vfadlan/atmostag/analysis-and-planning/README.md

# About This Section
This section is an engineering note about design process of this project. Some files on this will also be reposted on Hackaday.io.

## TODO
- CR2032 Analysis
- EPD Boost Driver Characteristic
- Power Budget: STM32L0, SHT41, UV Sensor, EPD Boost Driver
- State Machine
