vfadlan/atmostag/design-files/cad/references/cr2032-bs6-holder.webp

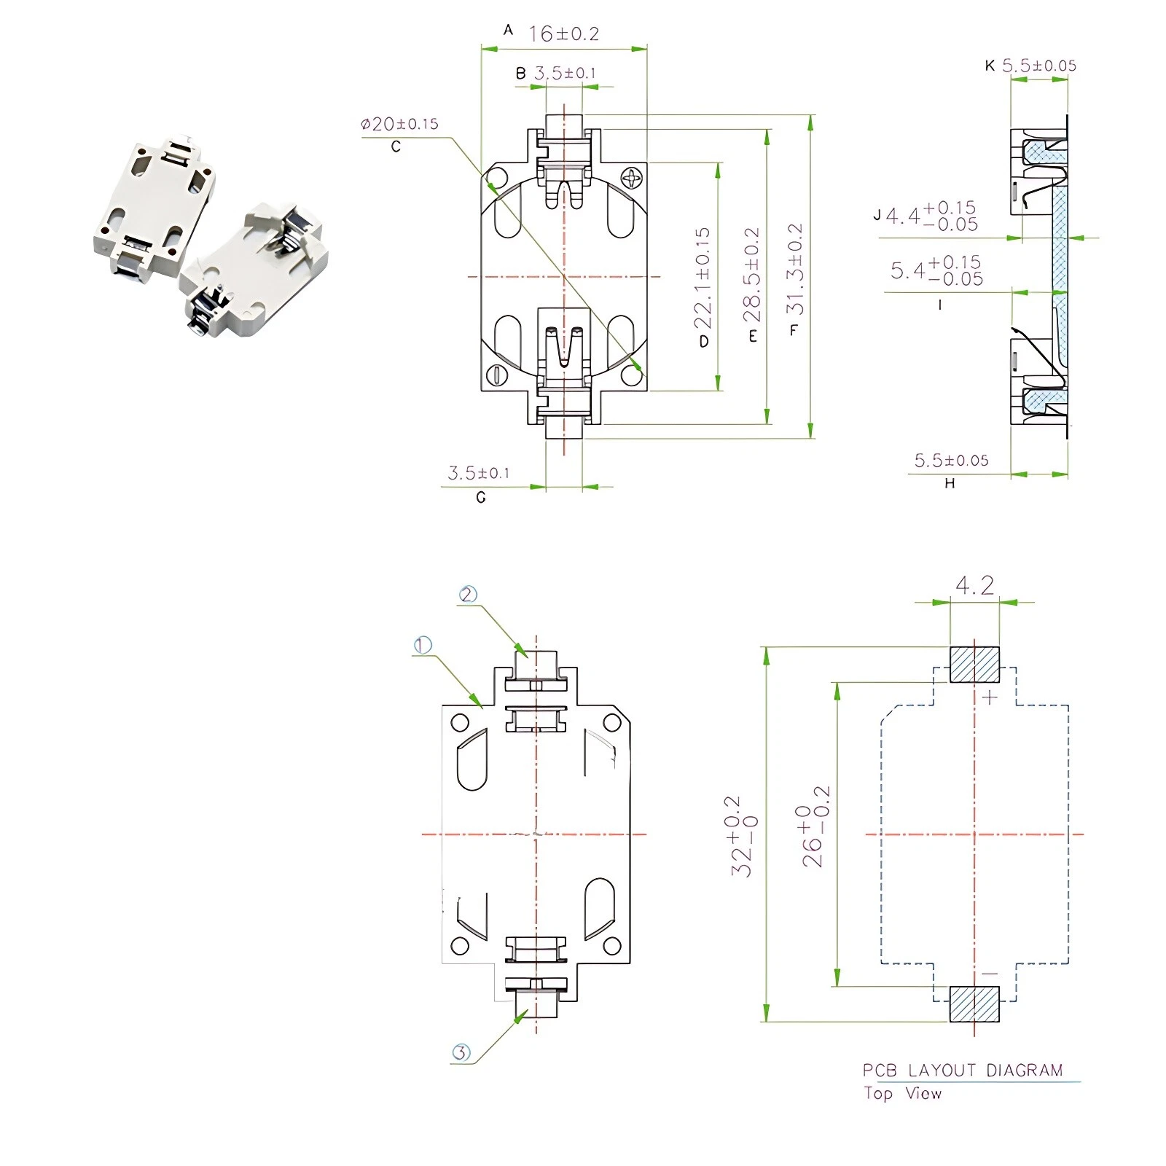
design-files/cad/references/cr2032-bs6-holder.webp
