vfadlan/atmostag/design-files/cosmetics/handdrawn-silkscreen-2.png

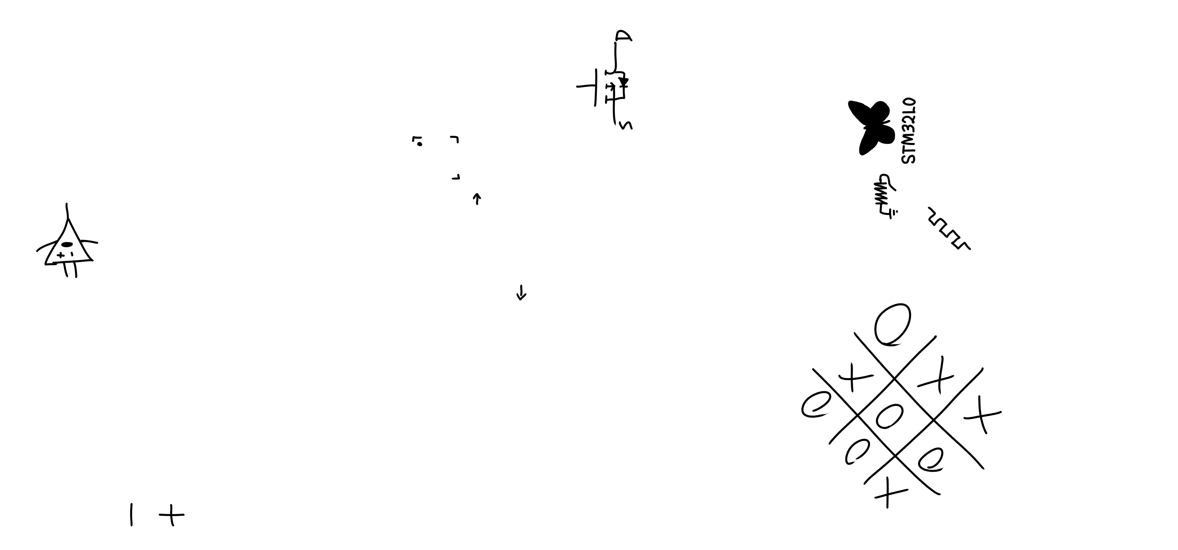
design-files/cosmetics/handdrawn-silkscreen-2.png
