vfadlan/atmostag/design-files/cosmetics/handdrawn-silkscreen.png

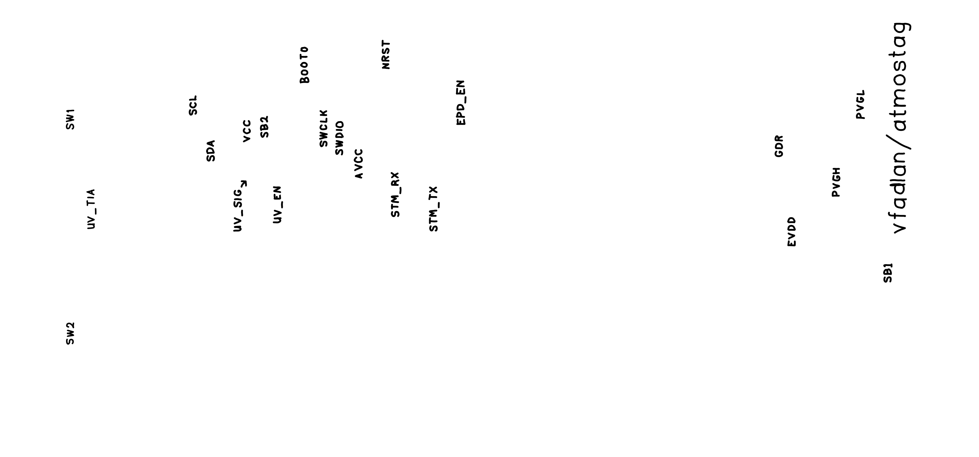
design-files/cosmetics/handdrawn-silkscreen.png
