vfadlan/atmostag/design-files/electrical/BOM_Main Board_AtmosTag_2026-10-05.csv

No. | Quantity | Comment | Designator | Footprint | Value | Manufacturer Part | Manufacturer | Supplier Part | Supplier | JLCPCB Stock | JLCPCB Price | LCSC Stock | LCSC Price | Category
1 | 1 | AGND | AGND | Test-Point-0.5mm |  |  |  |  |  |  |  |  | 0.0025
2 | 1 | AVCC | AVCC | Test-Point-0.5mm |  |  |  |  |  |  |  |  | 0.0025
3 | 1 | BOOT0 | BOOT0 | Test-Point-0.5mm |  |  |  |  |  |  |  |  | 0.0025
4 | 13 | 100nF | C1,C4,C5,C6,C8,C9,C10,C24,C25,C27,C30,C31,C32 | C0402 | 100nF | CL05B104KO5NNNC | SAMSUNG(三星) | C1525 | LCSC | 22154150 | 0.0007 |  |  | Capacitors:Multilayer Ceramic Capacitors MLCC - SMD/SMT
5 | 2 | 10pF | C2,C3 | C0402 | 10pF | CL05C100JB5NNNC | SAMSUNG(三星) | C32949 | LCSC | 1179858 | 0.0009 |  |  | Capacitors:Multilayer Ceramic Capacitors MLCC - SMD/SMT
6 | 2 | 100uF | C7,C23 | CASE-B_3528 | 100uF | TAJB107K006RNJ | Kyocera AVX | C16133 | LCSC | 612969 | 0.0397 |  |  | Capacitors:Tantalum Capacitors
7 | 10 | 1uF | C11,C12,C13,C14,C15,C16,C17,C18,C19,C20 | C0402 | 1uF | CL05A105KA5NQNC | SAMSUNG(三星) | C52923 | LCSC | 8338493 | 0.0017 |  |  | Capacitors:Multilayer Ceramic Capacitors MLCC - SMD/SMT
8 | 2 | 4.7uF | C21,C22 | C1206 | 4.7uF | 1206B475K500NT | FH(风华) | C29823 | LCSC | 592679 | 0.0252 |  |  | Capacitors:Multilayer Ceramic Capacitors MLCC - SMD/SMT
9 | 3 | 4.7uF | C26,C28,C33 | C0603 | 4.7uF | CL10A475KO8NNNC | SAMSUNG(三星) | C19666 | LCSC | 2518075 | 0.0045 |  |  | Capacitors:Multilayer Ceramic Capacitors MLCC - SMD/SMT
10 | 3 | MBR0530 | D1,D2,D3 | SOD-123_L2.7-W1.6-LS3.7-RD-1 |  | MBR0530 | DOWO(东沃) | C22378361 | LCSC | 3680 | 0.0022 |  |  | Diodes:Schottky Diodes
11 | 3 | ESD321DPYR-TP | D4,D5,D6 | X1SON-2_L1.0-W0.6-P0.65-RD |  | ESD321DPYR-TP | TECH PUBLIC(台舟) | C19829523 | LCSC | 19037 | 0.008 |  |  | Circuit Protection:ESD and Surge Protection (TVS/ESD)
12 | 1 | EPD_EN | EPD_EN | Test-Point-0.5mm |  |  |  |  |  |  |  |  | 0.0025
13 | 3 | Test-Point | EPD_VDD,TP1,TP2 | Test-Point-0.5mm |  |  |  |  |  |  |  |  | 0.0025
14 | 1 | FH34SRJ-24S-0.5SH(50) | FPC1 | FFC-SMD_24P-P0.50_FH34SRJ-24S-0.5SH |  | FH34SRJ-24S-0.5SH(50) | HRS(广濑) | C324726 | LCSC | 6516 | 0.0372 |  |  | Connectors:FFC, FPC (Flat Flexible) Connector Assemblies
15 | 1 | GDR | GDR | Test-Point-0.5mm |  |  |  |  |  |  |  |  | 0.0025
16 | 1 | GND | GND | Test-Point-0.5mm |  |  |  |  |  |  |  |  | 0.0025
17 | 1 | PZ254V-11-02P | H1 | HDR-TH_2P-P2.54-V-M |  | PZ254V-11-02P | XFCN(兴飞) | C492401 | LCSC | 1262495 | 0.0028 |  |  | Connectors:Pin Headers
18 | 1 | GZ2012D601TF | L1 | L0805 |  | GZ2012D601TF | Sunlord(顺络) | C1017 | LCSC | 366222 | 0.0031 |  |  | Filters:Ferrite Beads
19 | 3 | KT-0603W | LED1,LED2,LED3 | LED0603-R-RD_WHITE |  | KT-0603W | KENTO | C2290 | LCSC | 2115580 | 0.0019 |  |  | Optoelectronics:LED Indication - Discrete
20 | 1 | NRST | NRST | Test-Point-0.5mm |  |  |  |  |  |  |  |  | 0.0025
21 | 1 | GUVA-S12SD | PD1 | LED-SMD_L3.2-W2.8-RD |  | GUVA-S12SD | Genicom | C7200747 | LCSC | 0 | 1.8313 |  |  | Optoelectronics:Photodiodes
22 | 1 | PREVGH | PREVGH | Test-Point-0.5mm |  |  |  |  |  |  |  |  | 0.0025
23 | 1 | PREVGL | PREVGL | Test-Point-0.5mm |  |  |  |  |  |  |  |  | 0.0025
24 | 3 | AO3401A | Q1,Q2,Q4 | SOT-23_L2.9-W1.3-P1.90-LS2.4-BR |  | AO3401A | AOS | C15127 | LCSC | 757758 | 0.0153 |  |  | Transistors/Thyristors:MOSFETs
25 | 1 | SI1304BDL | Q3 | SOT-323-3_L2.0-W1.3-P1.30-LS2.1-BL |  | SI1304BDL | TECH PUBLIC(台舟) | C7419947 | LCSC | 3993 | 0.0091 |  |  | Transistors/Thyristors:MOSFETs
26 | 2 | 4.7kΩ | R1,R2 | R0603 | 4.7kΩ | 0603WAF4701T5E | UNI-ROYAL(厚声) | C23162 | LCSC | 22388782 | 0.0005 |  |  | Resistors:Chip Resistor - Surface Mount
27 | 1 | 1MΩ | R3 | R0603 | 1MΩ | 0603WAF1004T5E | UNI-ROYAL(厚声) | C22935 | LCSC | 6583768 | 0.0003 |  |  | Resistors:Chip Resistor - Surface Mount
28 | 1 | 3.3kΩ | R4 | R0402 | 3.3kΩ | 0402WGF3301TCE | UNI-ROYAL(厚声) | C25890 | LCSC | 2081969 | 0.0006 |  |  | Resistors:Chip Resistor - Surface Mount
29 | 3 | 1kΩ | R5,R6,R14 | R0402 | 1kΩ | 0402WGF1001TCE | UNI-ROYAL(厚声) | C11702 | LCSC | 7096292 | 0.0003 |  |  | Resistors:Chip Resistor - Surface Mount
30 | 1 | 2.2kΩ | R7 | R0402 | 2.2kΩ | 0402WGF2201TCE | UNI-ROYAL(厚声) | C25879 | LCSC | 2212616 | 0.0002 |  |  | Resistors:Chip Resistor - Surface Mount
31 | 2 | 470kΩ | R8,R11 | R0603 | 470kΩ | 0603WAF4703T5E | UNI-ROYAL(厚声) | C23178 | LCSC | 1450342 | 0.0005 |  |  | Resistors:Chip Resistor - Surface Mount
32 | 2 | 0Ω | R9,R18 | R0603 | 0Ω | 0603WAF0000T5E | UNI-ROYAL(厚声) | C21189 | LCSC | 23699129 | 0.0004 |  |  | Resistors:Chip Resistor - Surface Mount
33 | 1 | 3Ω | R10 | R0603 | 3Ω | ESR03EZPF3R00 | ROHM(罗姆) | C3960622 | LCSC | 753 | 0.002 |  |  | Resistors:Chip Resistor - Surface Mount
34 | 2 | 10kΩ | R12,R17 | R0402 | 10kΩ | 0402WGF1002TCE | UNI-ROYAL(厚声) | C25744 | LCSC | 21656419 | 0.0006 |  |  | Resistors:Chip Resistor - Surface Mount
35 | 3 | 100Ω | R13,R15,R16 | R0603 | 100Ω | 0603WAF1000T5E | UNI-ROYAL(厚声) | C22775 | LCSC | 11539242 | 0.0005 |  |  | Resistors:Chip Resistor - Surface Mount
36 | 2 | Solder-Bridge-3P | SB1,SB2 | Solder-Bridge-3P |  |  |  |  |  |  |  |  | 0.0025
37 | 2 | G4R153312 | SW1,SW2 | SW-SMD_4P-L5.2-W5.2-P3.70-LS6.4_UK-B0233XX |  | G4R153312 | SAMZO(三佐) | C49393650 | LCSC | 3842 | 0.0133 |  |  | Switches:Tactile Switches
38 | 1 | SWCLK | SWCLK | Test-Point-0.5mm |  |  |  |  |  |  |  |  | 0.0025
39 | 1 | SWDIO | SWDIO | Test-Point-0.5mm |  |  |  |  |  |  |  |  | 0.0025
40 | 1 | STM32L031G6U6 | U1 | UFQFPN-28_L4.0-W4.0-P0.50-BL |  | STM32L031G6U6 | ST(意法半导体) | C96514 | LCSC | 0 | 0.2963 |  |  | Embedded Processors & Controllers:Microcontrollers (MCU/MPU/SOC)
41 | 1 | SHT41-P-NF | U2 | DFN-4_L1.5-W1.5-SHT41-AD1B-R2 |  | SHT41-P-NF | Nyfea(徕飞) | C55108905 | LCSC | 1541 | 0.2342 |  |  | Sensors:Temperature and Humidity Sensor
42 | 1 | MCP6002-I/MS | U3 | MSOP-8_L3.0-W3.0-P0.65-LS4.9-BL |  | MCP6002-I/MS | MICROCHIP(美国微芯) | C5121360 | LCSC | 65 | 0.1047 |  |  | Amplifiers/Comparators:Operational Amplifier
43 | 1 | CP2102N-A02-GQFN20R | U4 | QFN-20_L3.0-W3.0-P0.50-BL-EP1.7_EFM8BB21F16G |  | CP2102N-A02-GQFN20R | SKYWORKS/SILICON LABS(芯科) | C969913 | LCSC | 11364 | 0.2748 |  |  | Interface:USB Converters
44 | 1 | 47uH | U5 | IND-SMD_L3.0-W3.0_CDRH2D18-HPNP | 47uH | CDRH2D18/LDNP-470NC | Sumida(胜美达) | C2454210 | LCSC | 0 | 0.0834 |  |  | Inductors, Coils, Chokes:Power Inductors
45 | 2 | 74LVC1G126GW | U6,U7 | SOT-353-5_L2.0-W1.6-P0.65-LS2.1-BL |  | 74LVC1G126GW | MDD(辰达半导体) | C52140429 | LCSC | 4936 | 0.0102 |  |  | Logic:Buffers, Drivers, Receivers, Transceivers
46 | 1 | USB-MICRO XNJ JB | USB1 | MICRO-USB-SMD_HX-USB-MICRO-XNJ-JB |  | USB-MICRO XNJ JB | SHOU HAN(首韩) | C7507410 | LCSC | 18405 | 0.0059 |  |  | Connectors:USB Connectors
47 | 1 | UV_EN | UV_EN | Test-Point-0.5mm |  |  |  |  |  |  |  |  | 0.0025
48 | 1 | UV | UV_SEG | Test-Point-0.5mm |  |  |  |  |  |  |  |  | 0.0025
49 | 1 | TIA | UV_TIA | Test-Point-0.5mm |  |  |  |  |  |  |  |  | 0.0025
50 | 1 | VCC | VCC | Test-Point-0.5mm |  |  |  |  |  |  |  |  | 0.0025
51 | 1 | 32.768kHz | X1 | OSC-SMD_L3.2-W1.5 | 32.768kHz | SC-32S32.768kHz20PPM7pF | Seiko(精工) | C97604 | LCSC | 155016 | 0.0281 |  |  | Crystals, Oscillators, Resonators:Crystals
