vfadlan/atmostag/design-files/cad/Assembly.SLDASM

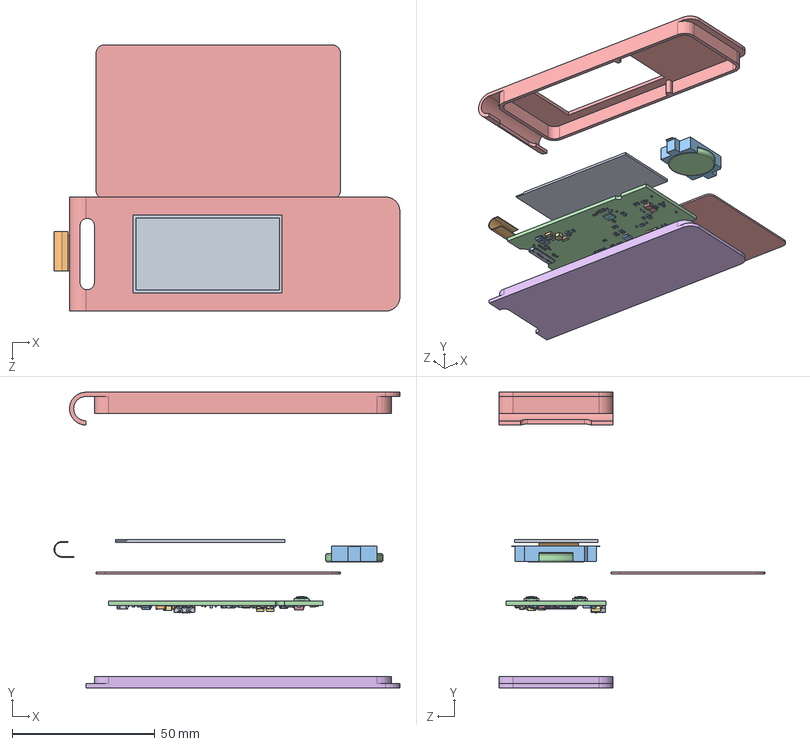
[picture p20: CAD file, 2026-10-23]
design-files/cad/Assembly.SLDASM
121.1 x 103.5 x 93.2 mm
2.13-EPD-Screen
Flex-Cable^Assembly
CR2032-BS6-Holder
CR2032
C0402~C0402_L1.0-W0.5-H0.5~13V8.step x 26
CASE-B_3528~CASE-B_L3.5-W2.8-H1.9~MT1c.step x 2
C0603~C0603_L1.6-W0.8-H0.8~z3cm.step x 3
X1SON-2_L1.0-W0.6-P0.65-RD~X1SON-2_L1.0-W0.6-P0.65-RD~nRyh.step x 3
C1206~C1206_L3.2-W1.6-H1.3~bCKY.step x 2
SOD-123_L2.7-W1.6-LS3.7-RD-1~SOD-123_L2.7-W1.6-LS3.7-RD-1~3PoL.step x 3
L0805~R0805_L2.0-W1.3-H0.6~qKtJ.step
LED-SMD_L3.2-W2.8-RD~LED-SMD_L3.5-W2.8-H1.4~aKe1.step
LED0603-R-RD_WHITE~LED0603-R-RD_WHITE~N99n.step x 3
SOT-323-3_L2.0-W1.3-P1.30-LS2.1-BL~SOT-323-3_L2.0-W1.3-P1.30-LS2.1-BL~gQnD.step
R0603~R0603~ZJ5j.step x 11
FFC-SMD_24P-P0.50_FH34SRJ-24S-0.5SH~FFC-SMD_24P-P0.50_FH34SRJ-24S-0.5SH~vgLo.step
R0402~R0402_L1.0-W0.5-H0.4~BaNc.step x 8
SOT-23_L2.9-W1.3-P1.90-LS2.4-BR~SOT-23-3P_L2.9-W1.3-H1.0-LS2.4-P0.95~FBFc.step x 3
SW-SMD_4P-L5.2-W5.2-P3.70-LS6.4_UK-B0233XX~SW-SMD_4P-L5.2-W5.2-H1.5-P3.70-LS5.4_UK-B0232XX~TJl1.step x 2
MSOP-8_L3.0-W3.0-P0.65-LS4.9-BL~MSOP-8_L3.0-W3.0-H1.1-LS4.9-P0.65~WqGd.step
DFN-4_L1.5-W1.5-SHT41-AD1B-R2~DFN-4_L1.5-W1.5-SHT41-AD1B-R2~EiRA.step
IND-SMD_L3.0-W3.0_CDRH2D18-HPNP~IND-SMD_L3.0-W3.0-H1.8_CDRH2D18-HPNP~dVXh.step
UFQFPN-28_L4.0-W4.0-P0.50-BL~UFQFPN-28_L4.0-W4.0-H0.6-P0.50~cQHD.step
MICRO-USB-SMD_HX-USB-MICRO-XNJ-JB~MICRO-USB-SMD_HX-USB-MICRO-XNJ-JB~raZj.step
OSC-SMD_L3.2-W1.5~OSC-SMD_L3.2-W1.5-H0.8~C9HM.step
QFN-20_L3.0-W3.0-P0.50-BL-EP1.7_EFM8BB21F16G~QFN-20_L3.0-W3.0-H0.8-P0.50~cjvo.step
Board~wIS8.step
Top-Shell^Assembly
Bottom-Shell^Assembly
