vfadlan/atmostag/design-files/cad/3DPCB_AtmosTag-v1.3_2026-10-09.SLDASM

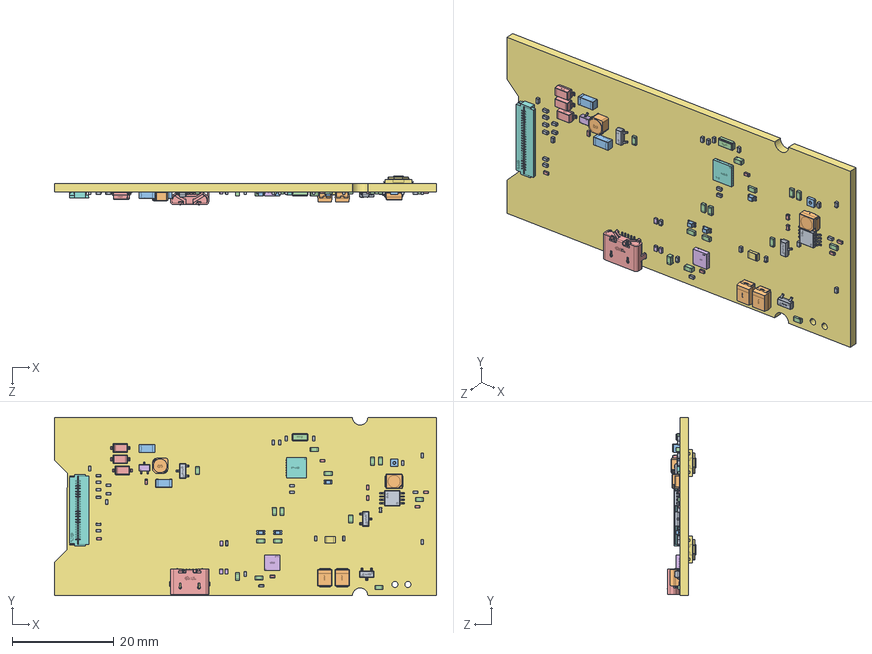
[picture p21: CAD file, 2026-10-23]
design-files/cad/3DPCB_AtmosTag-v1.3_2026-10-09.SLDASM
75.0 x 35.0 x 5.75 mm
C0402~C0402_L1.0-W0.5-H0.5~6r8q.step x 26
CASE-B_3528~CASE-B_L3.5-W2.8-H1.9~lpej.step x 2
C1206~C1206_L3.2-W1.6-H1.3~HpHm.step x 2
C0603~C0603_L1.6-W0.8-H0.8~5elm.step x 3
SOD-123_L2.7-W1.6-LS3.7-RD-1~SOD-123_L2.7-W1.6-LS3.7-RD-1~J5fz.step x 3
X1SON-2_L1.0-W0.6-P0.65-RD~X1SON-2_L1.0-W0.6-P0.65-RD~9xGz.step x 3
L0805~R0805_L2.0-W1.3-H0.6~Wi9K.step
FFC-SMD_24P-P0.50_FH34SRJ-24S-0.5SH~FFC-SMD_24P-P0.50_FH34SRJ-24S-0.5SH~g9HX.step
SOT-23_L2.9-W1.3-P1.90-LS2.4-BR~SOT-23-3P_L2.9-W1.3-H1.0-LS2.4-P0.95~2eBH.step x 3
LED-SMD_L3.2-W2.8-RD~LED-SMD_L3.5-W2.8-H1.4~j0iY.step
LED0603-R-RD_WHITE~LED0603-R-RD_WHITE~vOEA.step x 3
R0603~R0603~y4nU.step x 11
R0402~R0402_L1.0-W0.5-H0.4~89QX.step x 8
SOT-323-3_L2.0-W1.3-P1.30-LS2.1-BL~SOT-323-3_L2.0-W1.3-P1.30-LS2.1-BL~Mjdz.step
SW-SMD_4P-L5.2-W5.2-P3.70-LS6.4_UK-B0233XX~SW-SMD_4P-L5.2-W5.2-H1.5-P3.70-LS5.4_UK-B0232XX~Gqr3.step x 2
UFQFPN-28_L4.0-W4.0-P0.50-BL~UFQFPN-28_L4.0-W4.0-H0.6-P0.50~kUiK.step
MSOP-8_L3.0-W3.0-P0.65-LS4.9-BL~MSOP-8_L3.0-W3.0-H1.1-LS4.9-P0.65~v4GR.step
IND-SMD_L3.0-W3.0_CDRH2D18-HPNP~IND-SMD_L3.0-W3.0-H1.8_CDRH2D18-HPNP~sAZQ.step
DFN-4_L1.5-W1.5-SHT41-AD1B-R2~DFN-4_L1.5-W1.5-SHT41-AD1B-R2~CHCD.step
OSC-SMD_L3.2-W1.5~OSC-SMD_L3.2-W1.5-H0.8~YgzL.step
MICRO-USB-SMD_HX-USB-MICRO-XNJ-JB~MICRO-USB-SMD_HX-USB-MICRO-XNJ-JB~2A1r.step
QFN-20_L3.0-W3.0-P0.50-BL-EP1.7_EFM8BB21F16G~QFN-20_L3.0-W3.0-H0.8-P0.50~Kgs7.step
Board~EWOM.step
