vfadlan/atmostag/design-files/cad/PCB_Placeholder.SLDPRT

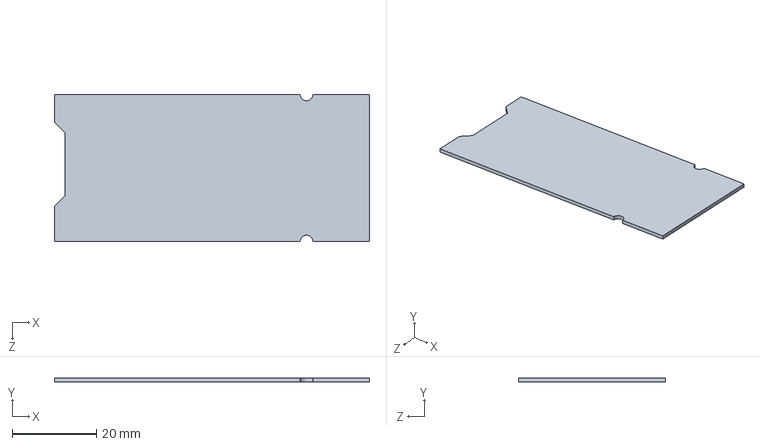
[picture p22: CAD file, 2026-10-23]
design-files/cad/PCB_Placeholder.SLDPRT
75.0 x 1.00 x 35.0 mm
