vfadlan/atmostag/design-files/cad/2.13-EPD-Screen.SLDPRT

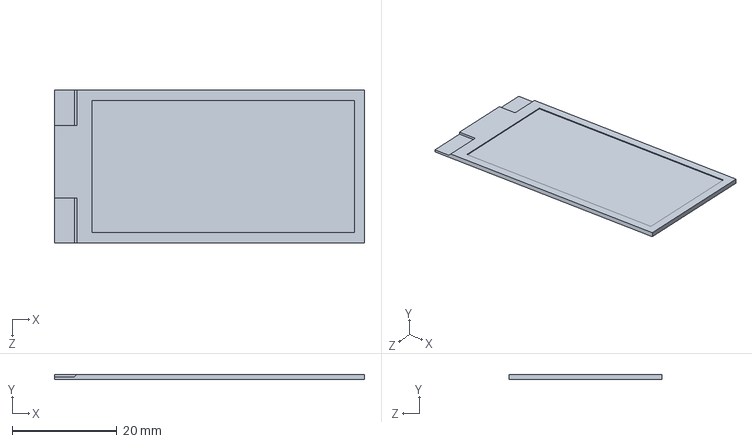
[picture p23: CAD file, 2026-10-23]
design-files/cad/2.13-EPD-Screen.SLDPRT
59.2 x 1.00 x 29.2 mm
