vfadlan/atmostag/design-files/cad/CR2032-BS6-Holder.SLDPRT

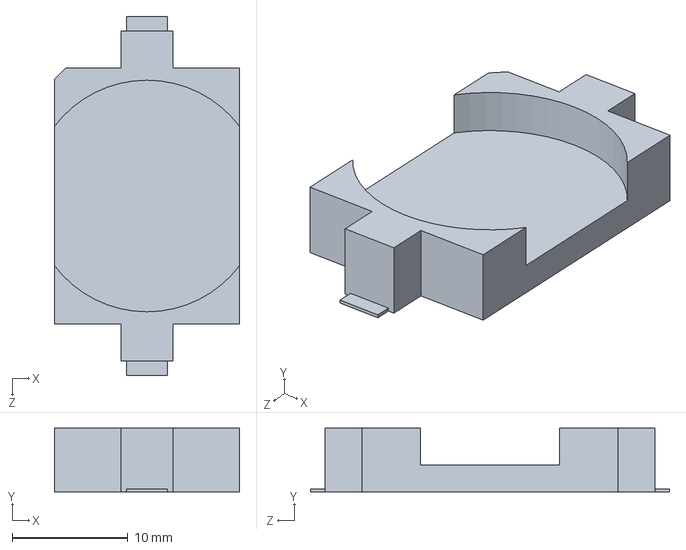
[picture p24: CAD file, 2026-10-23]
design-files/cad/CR2032-BS6-Holder.SLDPRT
16.0 x 5.50 x 31.0 mm
