vfadlan/atmostag/design-files/cad/CR2032.SLDPRT

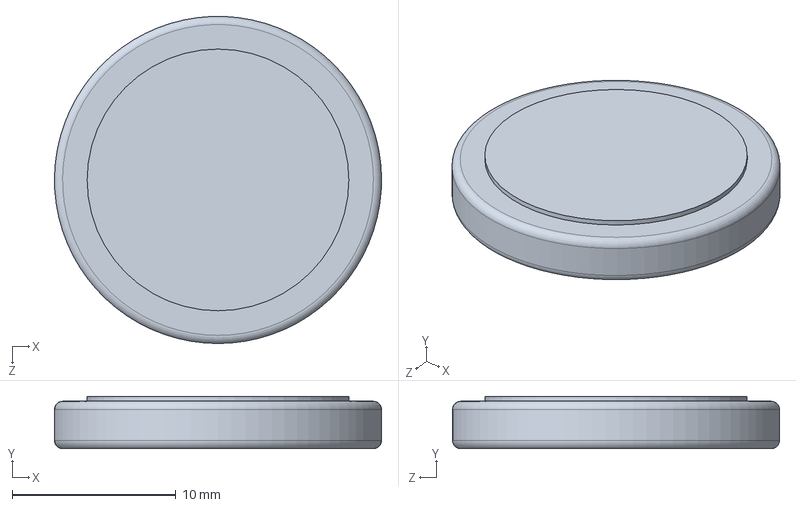
[picture p25: CAD file, 2026-10-23]
design-files/cad/CR2032.SLDPRT
20.0 x 3.20 x 20.0 mm
