vfadlan/atmostag/(list of files, cad)

Other CAD files:
design-files/cad/3D_AtmosTag-v1.3_2026-10-09.SLDASM
