vfadlan/atmostag/design-files/electrical/AtmosTag-v1.5-schematic.pdf

# MCU

# UV Sensor

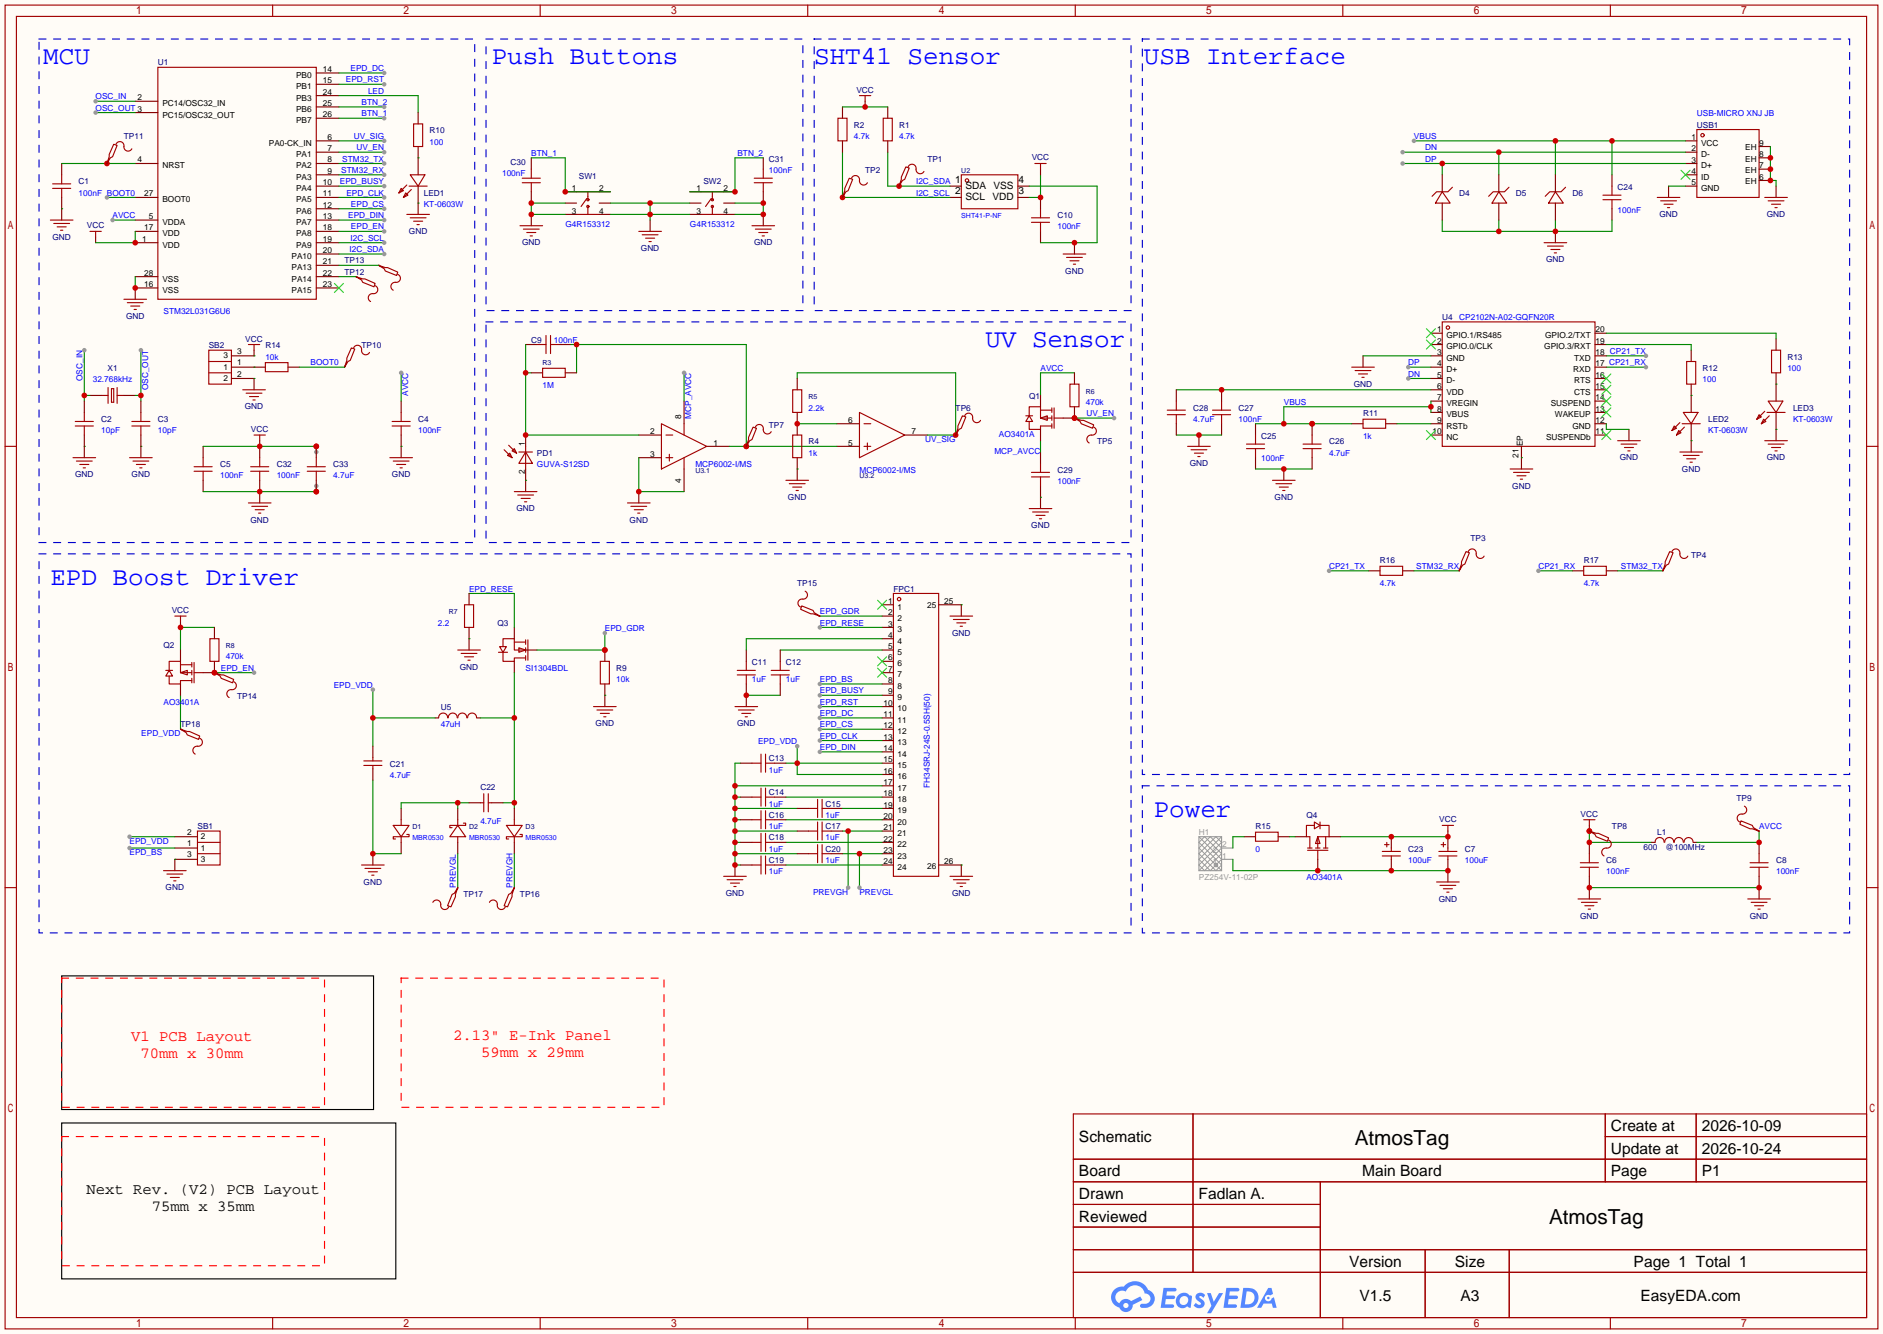
[picture p26: page 1]

Schematic | AtmosTag | Create at | 2026-10-09

Update at | 2026-10-24

Board | Main Board | Page | P1
Drawn | Fadlan A. | AtmosTag
Reviewed

Next Rev. (V2) PCB Layout

Version | Size | Page 1 Total 1
V1.5 | A3 | EasyEDA.com
