vfadlan/atmostag/design-files/electrical/low-ink-keychain-v1.1-schematic.pdf

# OSC_OUT OSC_IN

# UV Sensor

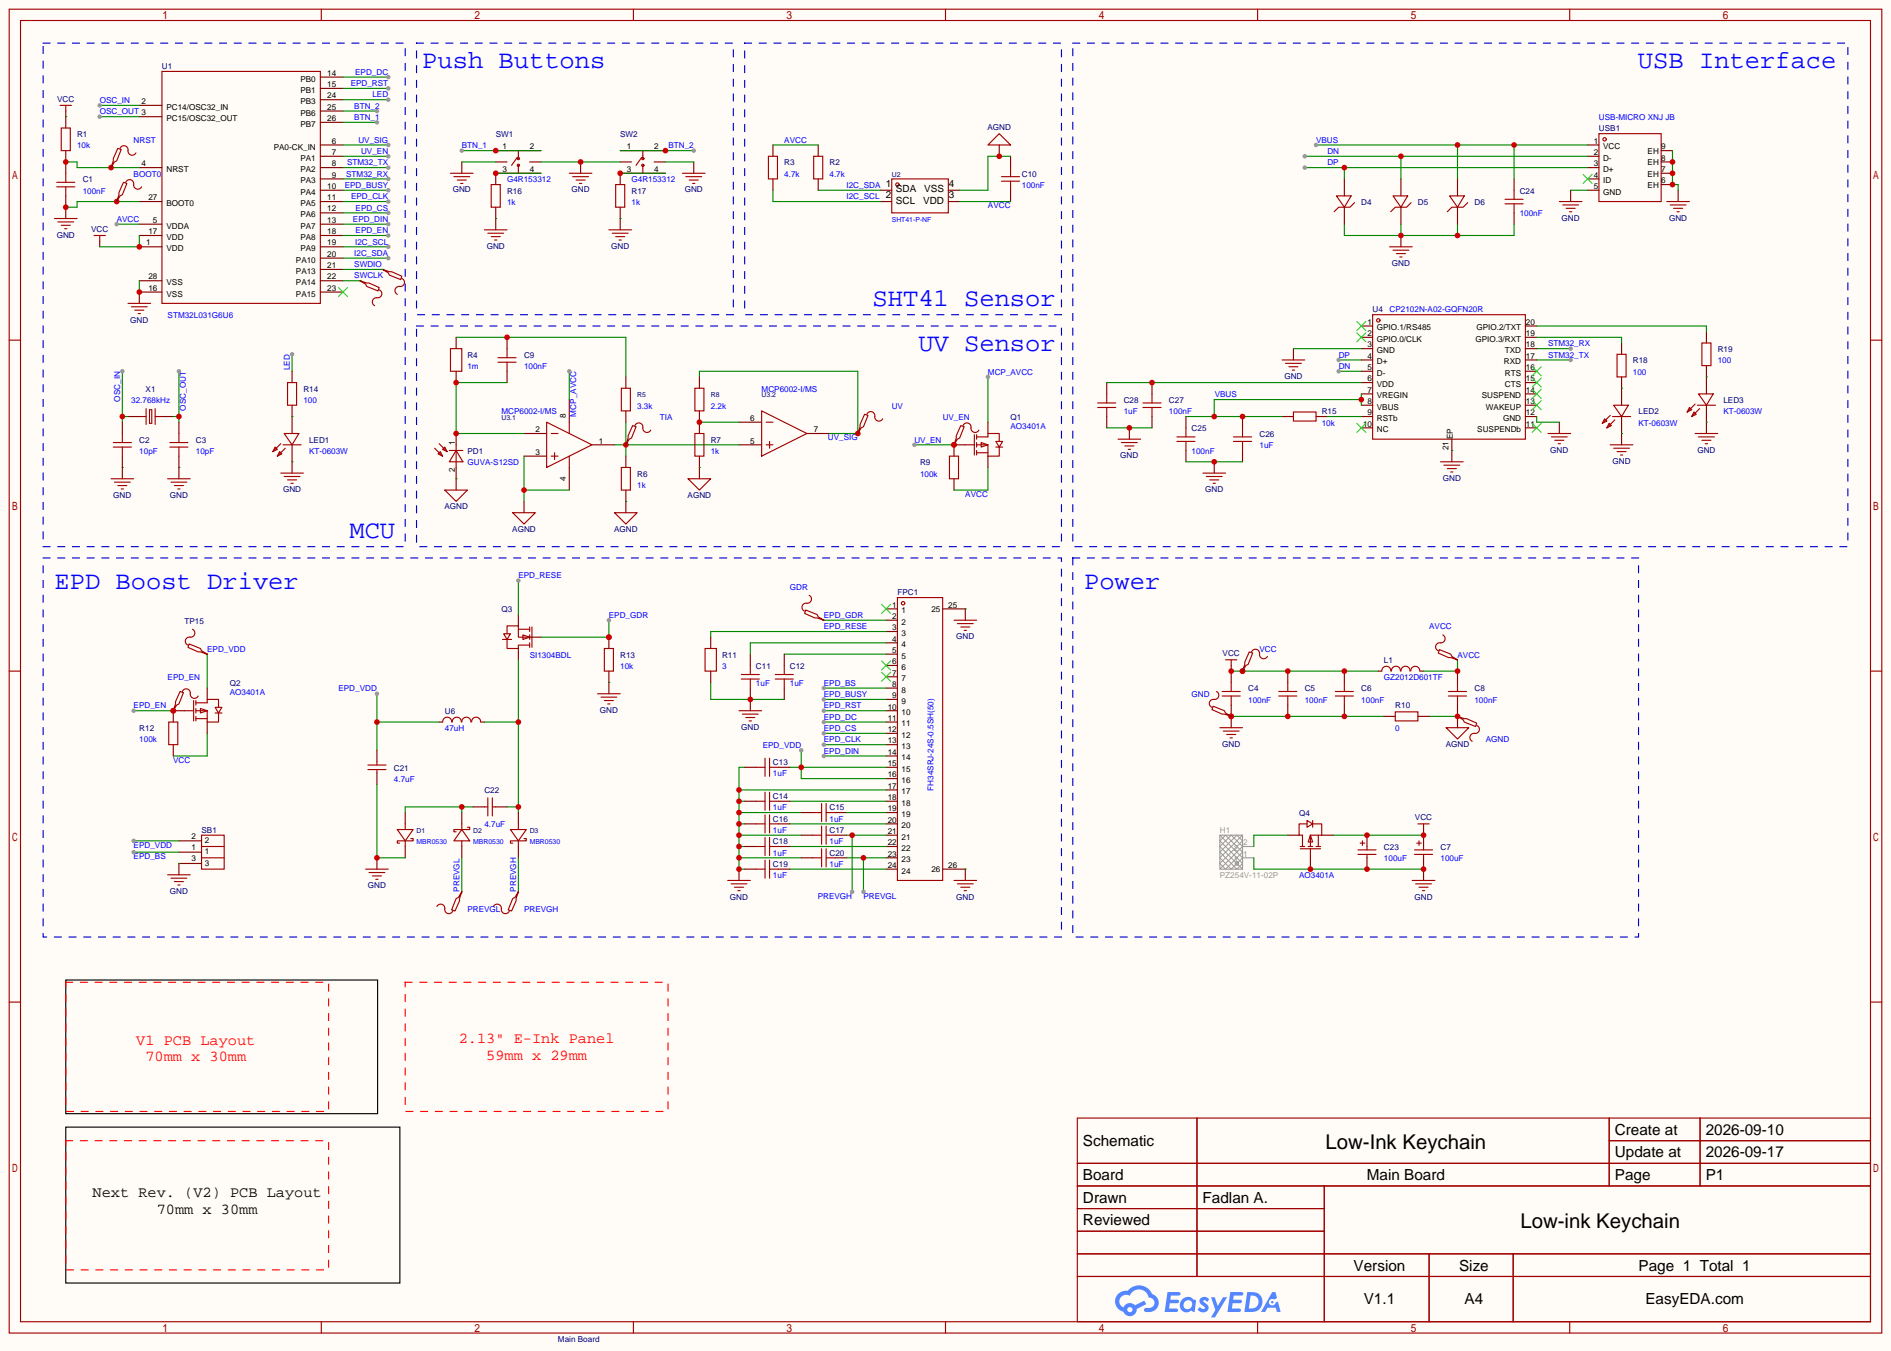
[picture p27: page 1]

Schematic | Low-Ink Keychain | Create at | 2026-09-10

Update at | 2026-09-17

Board | Main Board | Page | P1
Drawn | Fadlan A. | Low-ink Keychain
Reviewed

Next Rev. (V2) PCB Layout

Version | Size | Page 1 Total 1
V1.1 | A4 | EasyEDA.com
