vfadlan/atmostag/simulations/GUVA-S12SD/sim.asc

C1: cap; 100nF; V=16
I1: current; 135nA
R1: res; 1Meg; tol=1 pwr=1/16
R2: res; 1k; tol=1 pwr=1/16
R3: res; 3.32K; tol=1 pwr=1/16
R4: res; 2.2k; tol=1 pwr=1/16
R5: res; 1k; tol=1 pwr=1/16
V1: voltage; 3v; Rser=10
Named nets: 0, UV_SIG, VCC
.dc I1 0n 300n 1n
.options gmindc=1e-11 reltol=1e-3
