vfadlan/atmostag/simulations/EPD-Boost-Driver/epd-boost-driver/boost_circuit.kicad_sch

## KiCad design simulations/EPD-Boost-Driver/epd-boost-driver/boost_circuit.kicad_sch (2026-10-25)

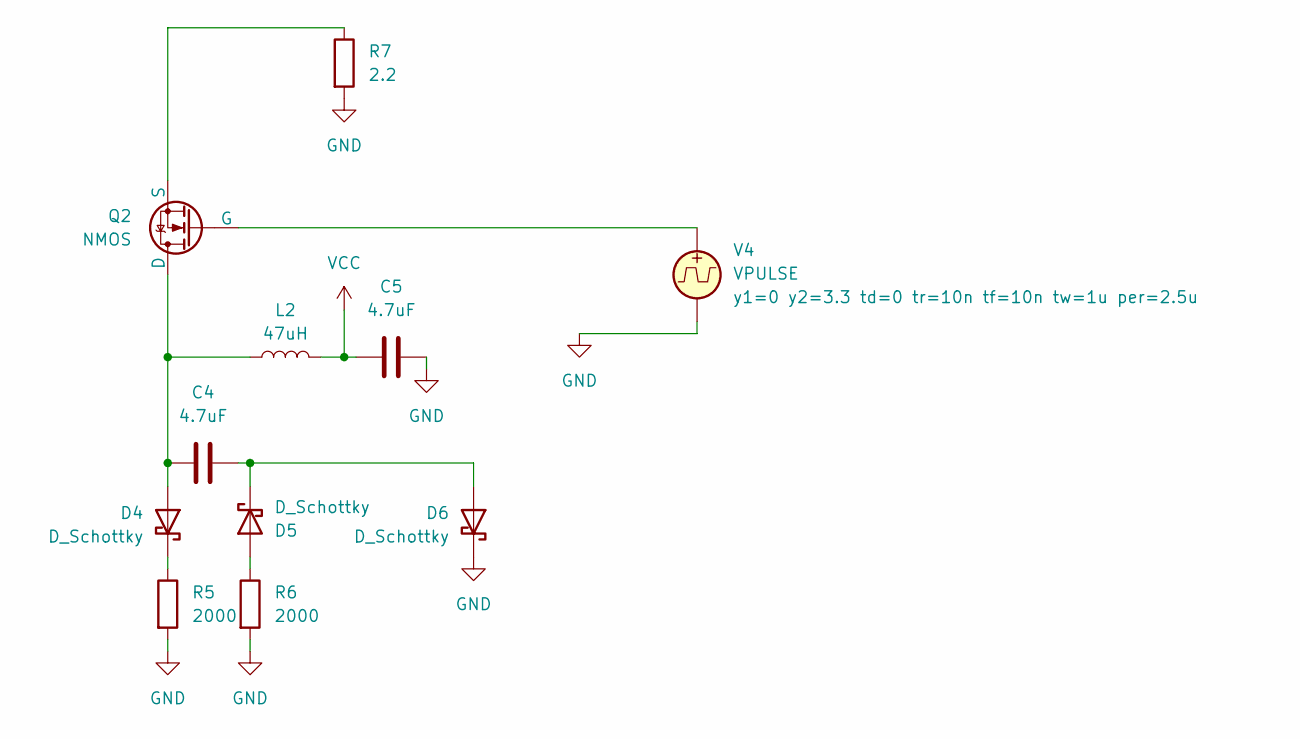
[picture p28: schematic boost_circuit.kicad_sch]

Parts:
C4, C5: 4.7uF
D4, D5, D6: D_Schottky
L2: 47uH
Q2: NMOS
R5, R6: 2000
R7: 2.2
V4: VPULSE

Connections:
GND: C5.2, D6.1 (K), R5.2, R6.2, R7.2, V4.2
unnamed: C4.1, D4.2 (A), L2.1, Q2.1 (D)
unnamed: C4.2, D5.1 (K), D6.2 (A)
unnamed: D4.1 (K), R5.1
unnamed: D5.2 (A), R6.1
unnamed: Q2.2 (G), V4.1
unnamed: Q2.3 (S), R7.1
VCC: C5.1, L2.2
