vfadlan/atmostag/simulations/EPD-Boost-Driver/epd-boost-driver/epd-boost-driver.kicad_sch

## KiCad design simulations/EPD-Boost-Driver/epd-boost-driver/epd-boost-driver.kicad_sch (2026-10-25)

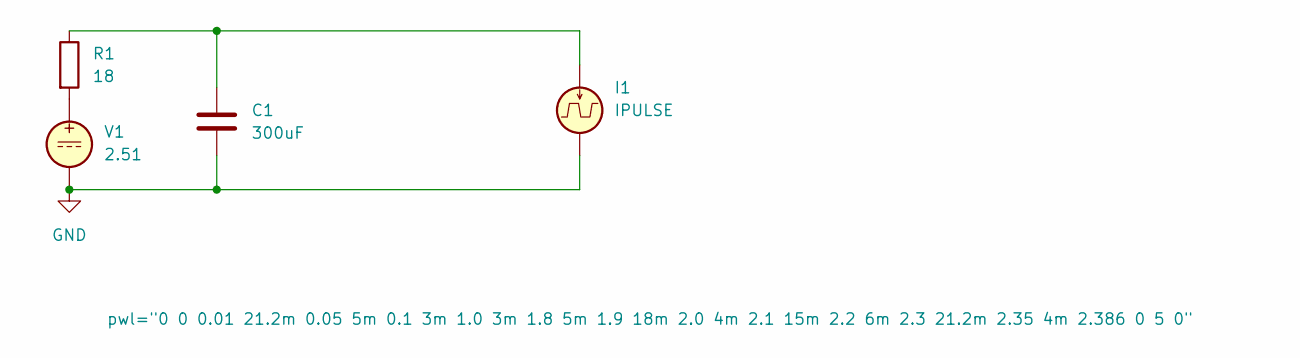
[picture p29: schematic epd-boost-driver.kicad_sch]

Parts:
C1: 300uF
I1: IPULSE
R1: 18
V1: 2.51

Connections:
GND: C1.2, I1.2, V1.2
unnamed: C1.1, I1.1, R1.1
unnamed: R1.2, V1.1
