vfadlan/atmostag/simulations/GUVA-S12SD/TIA-OPAMP/TIA-OPAMP.kicad_sch

## KiCad design simulations/GUVA-S12SD/TIA-OPAMP/TIA-OPAMP.kicad_sch (2026-10-24)

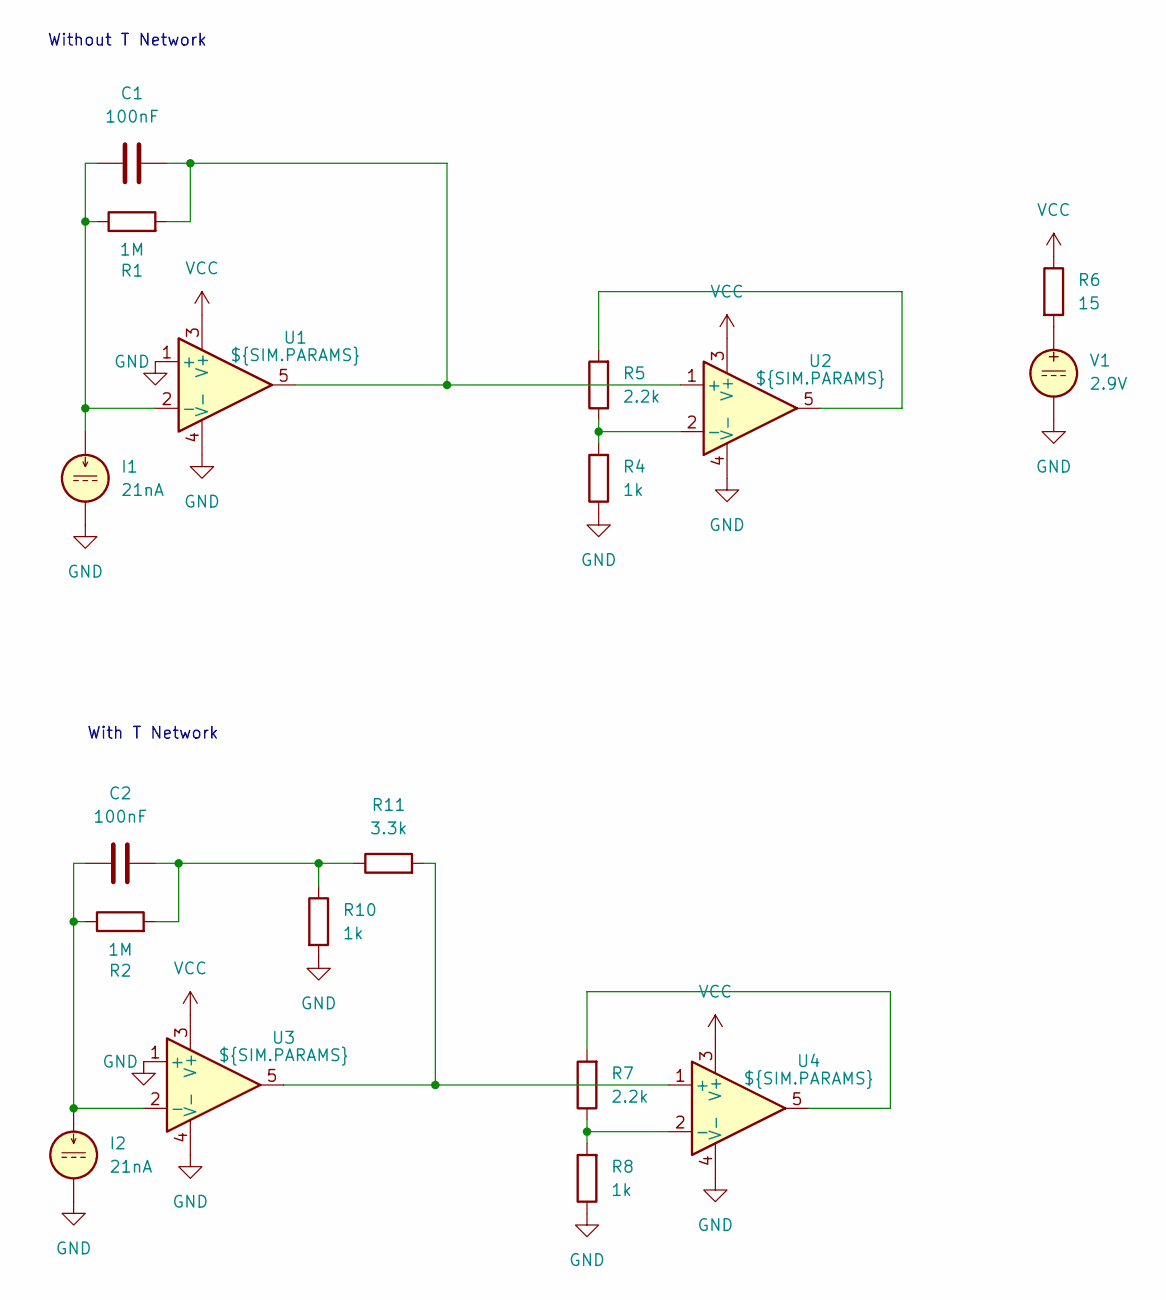
[picture p30: schematic TIA-OPAMP.kicad_sch]

Parts:
C1, C2: 100nF
I1, I2: 21nA
R1, R2: 1M
R4, R8, R10: 1k
R5, R7: 2.2k
R6: 15
R11: 3.3k
U1, U2, U3, U4: ${SIM.PARAMS}
V1: 2.9V

Connections:
GND: I1.2, I2.2, R4.1, R8.1, R10.2, U1.1 (+), U1.4 (V-), U2.4 (V-), U3.1 (+), U3.4 (V-), U4.4 (V-), V1.2
unnamed: C1.1, I1.1, R1.1, U1.2 (-)
unnamed: C1.2, R1.2, U1.5, U2.1 (+)
unnamed: C2.1, I2.1, R2.1, U3.2 (-)
unnamed: C2.2, R2.2, R10.1, R11.1
unnamed: R4.2, R5.1, U2.2 (-)
unnamed: R5.2, U2.5
unnamed: R6.2, V1.1
unnamed: R7.1, R8.2, U4.2 (-)
unnamed: R7.2, U4.5
unnamed: R11.2, U3.5, U4.1 (+)
VCC: R6.1, U1.3 (V+), U2.3 (V+), U3.3 (V+), U4.3 (V+)

Notes on the sheet:
With T Network
Without T Network
