vfadlan/atmostag/(commit log)

2026-10-24 simulate voltage drop during epd refresh
2026-10-24 remove T-Net on UV Sensor Frontend
